ItzShubhamDev/esp32/README.md

# ESP32 Board
A custom ESP32-S3 board utilizing USB-C and exposing a lots of pins.
3D_PCB1_2025-09-17 - Copy

## Schematic
SCH_Schematic1_1-P1_2025-09-17

## PCB


<br />



## 3D
3D_PCB1_2025-09-17
3D_PCB1_2025-09-17-1
