ItzShubhamDev/esp32/pcb/PCB1.png

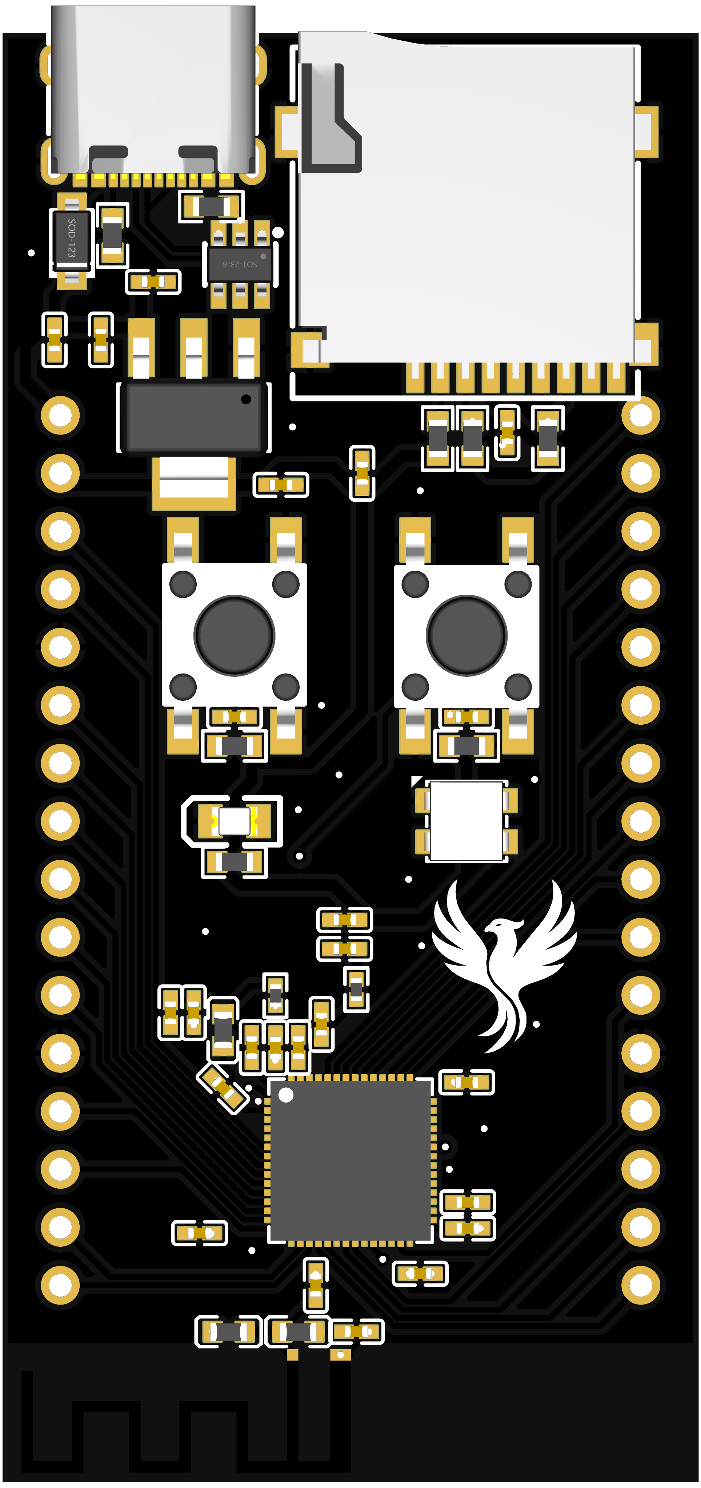
pcb/PCB1.png
