ItzShubhamDev/esp32/pcb/PCB2.png

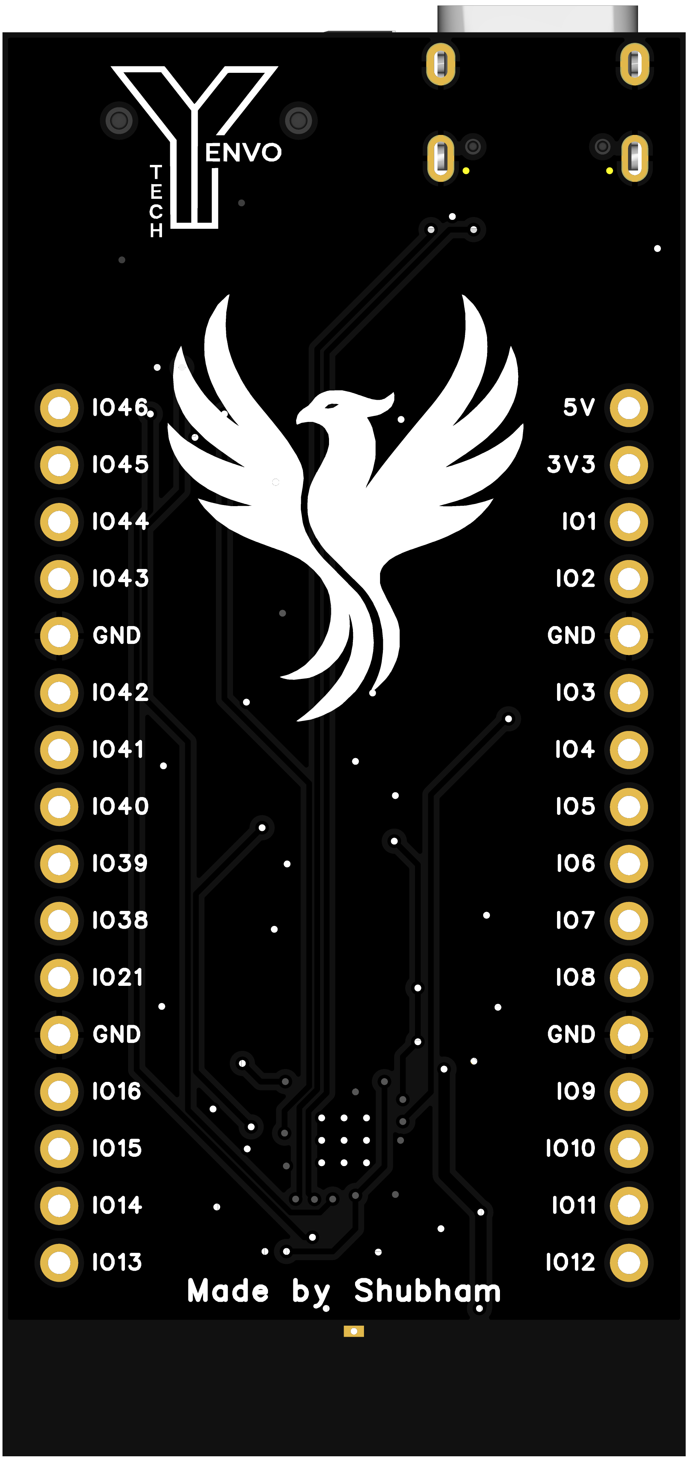
pcb/PCB2.png
