ItzShubhamDev/esp32/pcb/Schematic.png

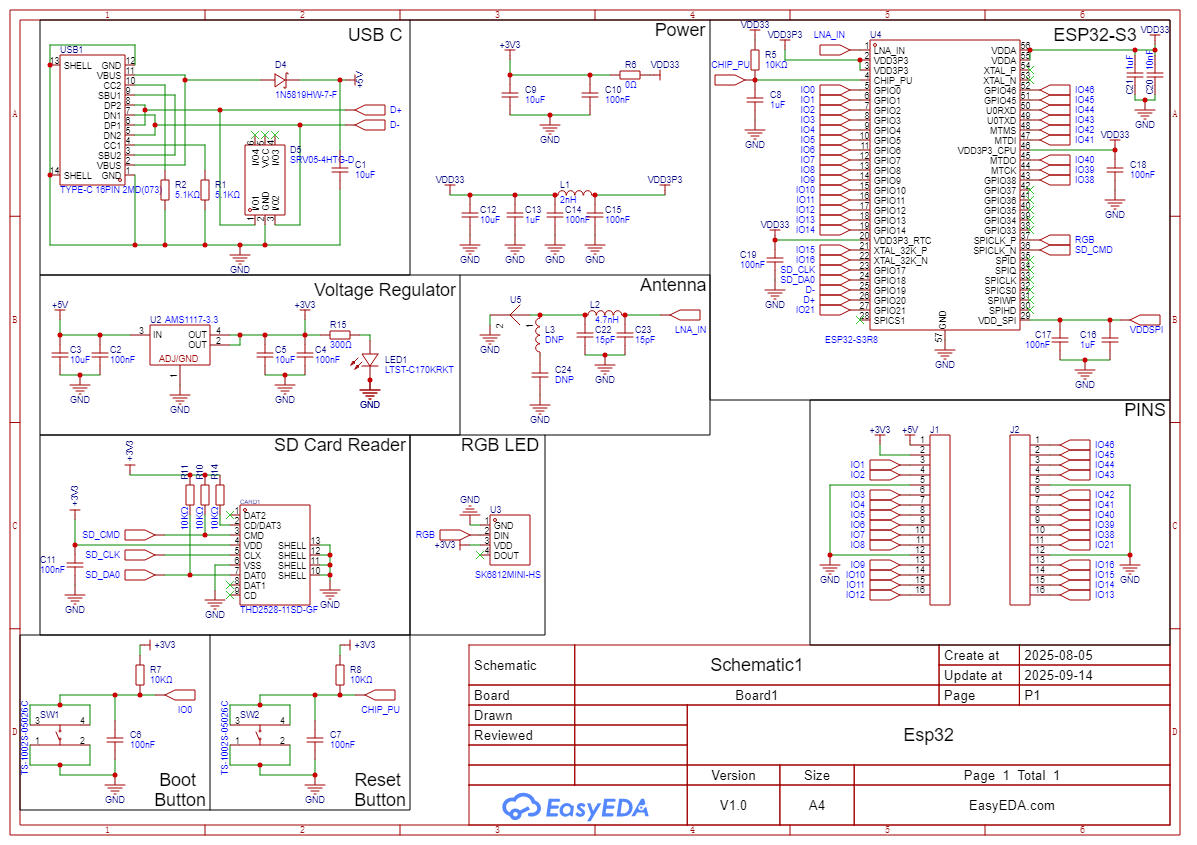
pcb/Schematic.png
