ItzShubhamDev/esp32/production/BOM.csv

No. | Quantity | Comment | Designator | Footprint | Value | Manufacturer Part | Manufacturer | Supplier Part | Supplier
1 | 5 | 10uF | C1,C3,C5,C9,C12 | C0402 | 10uF
2 | 11 | 100nF | C2,C4,C6,C7,C10,C11,C14,C15,C17,C18,C19 | C0402 | 100nF |  |  | C1525
3 | 4 | 1uF | C8,C13,C16,C21 | C0402 | 1uF
4 | 1 | 10nF | C20 | C0402 | 10nF
5 | 2 | 15pF | C22,C23 | C0402 | 15pF
6 | 1 | DNP | C24 | C0402 | DNP
7 | 1 | THD2528-11SD-GF | CARD1 | TF-SMD_THD2528-11SD-GF |  | THD2528-11SD-GF | THD(台华达) | C283232 | LCSC
8 | 1 | 1N5819HW-7-F | D4 | SOD-123_L2.7-W1.6-LS3.7-RD |  | 1N5819HW-7-F | DIODES(美台) | C82544 | LCSC
9 | 1 | SRV05-4HTG-D | D5 | SOT-23-6_L2.9-W1.6-P0.95-LS2.8-BR |  | SRV05-4HTG-D | Littelfuse(美国力特) | C1975211 | LCSC
10 | 2 | Conn_1x16 | J1,J2 | PinHeader_1x16_P2.54mm_Vertical
11 | 1 | 2nH | L1 | L0603 | 2nH | VHF160808H2N0ST | FH(风华) | C395081 | LCSC
12 | 1 | 4.7nH | L2 | L0603 | 4.7nH | VHF160808H4N7ST | FH(风华) | C1030 | LCSC
13 | 1 | DNP | L3 | L0603 | DNP
14 | 1 | LTST-C170KRKT | LED1 | LED0805-R-RD |  | LTST-C170KRKT | LITEON(光宝) | C94868 | LCSC
15 | 2 | 5.1KΩ | R1,R2 | R0603 | 5.1KΩ
16 | 1 | 10KΩ | R5 | R0402 | 10KΩ
17 | 1 | 0Ω | R6 | R0402 | 0Ω
18 | 5 | 10KΩ | R7,R8,R10,R11,R14 | R0603 | 10KΩ
19 | 1 | 300Ω | R15 | R0603 | 300Ω
20 | 2 | TS-1002S-05026C | SW1,SW2 | KEY-SMD_4P-L6.0-W6.0-P4.50-LS9.0 |  | TS-1002S-05026C | XUNPU(讯普) | C455110 | LCSC
21 | 1 | AMS1117-3.3 | U2 | SOT-223-3_L6.4-W3.5-P2.30-LS7.0-BR |  | AMS1117-3.3 | 国芯佳品 | C2992570 | LCSC
22 | 1 | SK6812MINI-HS | U3 | LED-SMD_4P-L3.5-W3.5-BR_SK6812MINI-HS |  | SK6812MINI-HS | 欧思科光电 | C2922787 | LCSC
23 | 1 | ESP32-S3R8 | U4 | QFN-56_L7.0-W7.0-P0.40-TL-EP4.0 |  | ESP32-S3R8 | ESPRESSIF(乐鑫) | C2913194 | LCSC
24 | 1 | Texas_SWRA117D_2.4GHz_Right | U5 | Texas_SWRA117D_2.4GHz_Right
25 | 1 | TYPE-C 16PIN 2MD(073) | USB1 | USB-C-SMD_TYPE-C-6PIN-2MD-073 |  | TYPE-C 16PIN 2MD(073) | SHOU HAN(首韩) | C2765186 | LCSC
