ItzShubhamDev/esp32/(list of files, drawings)

Other design files:
Esp32.eprj
