ItzShubhamDev/esp32/JOURNAL.md

---
Title: "ESP 32 Board"
Author: "Shubham"
Description: "A board for ESP32 S3"
Created On: "5/8/2025"
Total Time: 34h
---

# August 5th: Made the USB-C Input and Voltage regulator!

Did a research on ESP32 S3 boards looked out ESP32 S3 Devkit and it's [schematic](https://dl.espressif.com/dl/SCH_ESP32-S3-DEVKITC-1_V1_20210312C.pdf) to learn about the wiring and made my own USB-C input and a voltage regulator to step down voltage from 5V to 3.3V for safer operation of the chip.



**Time spent: 4h**

# August 6th: Completed the schematic!

Did a research on safe pins to expose of the board, added Red LED, RGB LED, SD Card Reader, Boot and Reset Buttons and Connections Pins.

SCH_Schematic1_1-P1_2025-08-07

**Time spent: 8h**

# August 7th: Modified the schematic and completed 70% routing!

Modified the schematic to make some adjustments to the pins connections and added traces for almost every connection except for the GND and 2-3 more remaining.
SCH_Schematic1_1-P1_2025-08-08







**Time spent: 6h**

# August 8th: Completed the PCB!

After completing the PCB I went through a final check and the microSD reader wasn't avaiable, so had to replace the microSD reader in schematic and redo that section, also I fixed the wrong pins of the left side of the board and added pin names on the bottom layer.





**Time spent: 6h**

# August 23rd: Replaced ESP32-S3-WROOM with ESP32-S3-IC

After completing all the things, someone suggested me to use ICs instead of Wrooms to gain more knowledge about boards, chips and overall electronics.

SCH_Schematic1_1-P1_2025-08-23

**Time spent: 2h**

# September 11th: Completed the schematic with the new IC.

I will be using ESP32-S3-PICO-1-N8R8, so made the schematic around that, the hardest part was Antenna, I had to read atleast 5 articles to get some info on the antennas.

SCH_Schematic1_1-P1_2025-09-12

**Time spent: 4h**

# September 13th: Completed the routing.

Completed all the routing for the PCB.



**Time spent: 2h**

# September 14th: Redid the routing.

After completing the routing I realised that the 5V was going all way the down from the USBC which wasn't intentional and not like what I originally thought and the made the schematic for, so I unrouted everything, redid the schemtic with the new pins and repositioned chip and pins and did the routing again.




**Time spent: 2h**
