ItzShubhamDev/esp32/firmware/led_blink.c

#include "freertos/FreeRTOS.h"
#include "freertos/task.h"
#include "driver/gpio.h"

#define LED_PIN GPIO_NUM_32

void app_main(void)
{
    gpio_reset_pin(LED_PIN);
    gpio_set_direction(LED_PIN, GPIO_MODE_OUTPUT);

    while (1) {
        gpio_set_level(LED_PIN, 1);
        vTaskDelay(500 / portTICK_PERIOD_MS);
        gpio_set_level(LED_PIN, 0);
        vTaskDelay(500 / portTICK_PERIOD_MS);
    }
}
