ItzShubhamDev/esp32/(commit log)

2025-08-15 Add project files
    [BOM.csv, Esp32.eprj, PickAndPlace.csv]
2025-08-18 Replaced Wroom with IC
    [Esp32.eprj]
2025-08-24 Completed connections between IC and components
    [Esp32.eprj]
2025-08-31 Completed the PCB.
    [Esp32.eprj]
2025-09-11 Updated Schematic
    [Esp32.eprj]
2025-09-14 Completed Routing
    [Esp32.eprj]
2025-09-14 Completed the routing and silkscreens.
    [Esp32.eprj]
2025-09-16 Completed the routing.
    [Esp32.eprj]
2025-09-17 Update files
    [BOM.csv, Esp32.eprj, PickAndPlace.csv]
2025-09-18 Update PCB schematic and images
2025-09-30 Add LED blinking firmware
